ThomasKruger1234/EEE3088F-Project-2025/README.md

This repo contains the PCB design for the power distribution subsystem of a micromouse robot.

This design was created in fullfilment of the requirements of EEE3088F (UCT, 2025)
