ThomasKruger1234/EEE3088F-Project-2025/EEE3088F Project.kicad_pcb

## KiCad design EEE3088F Project.kicad_pcb (2025-03-28)

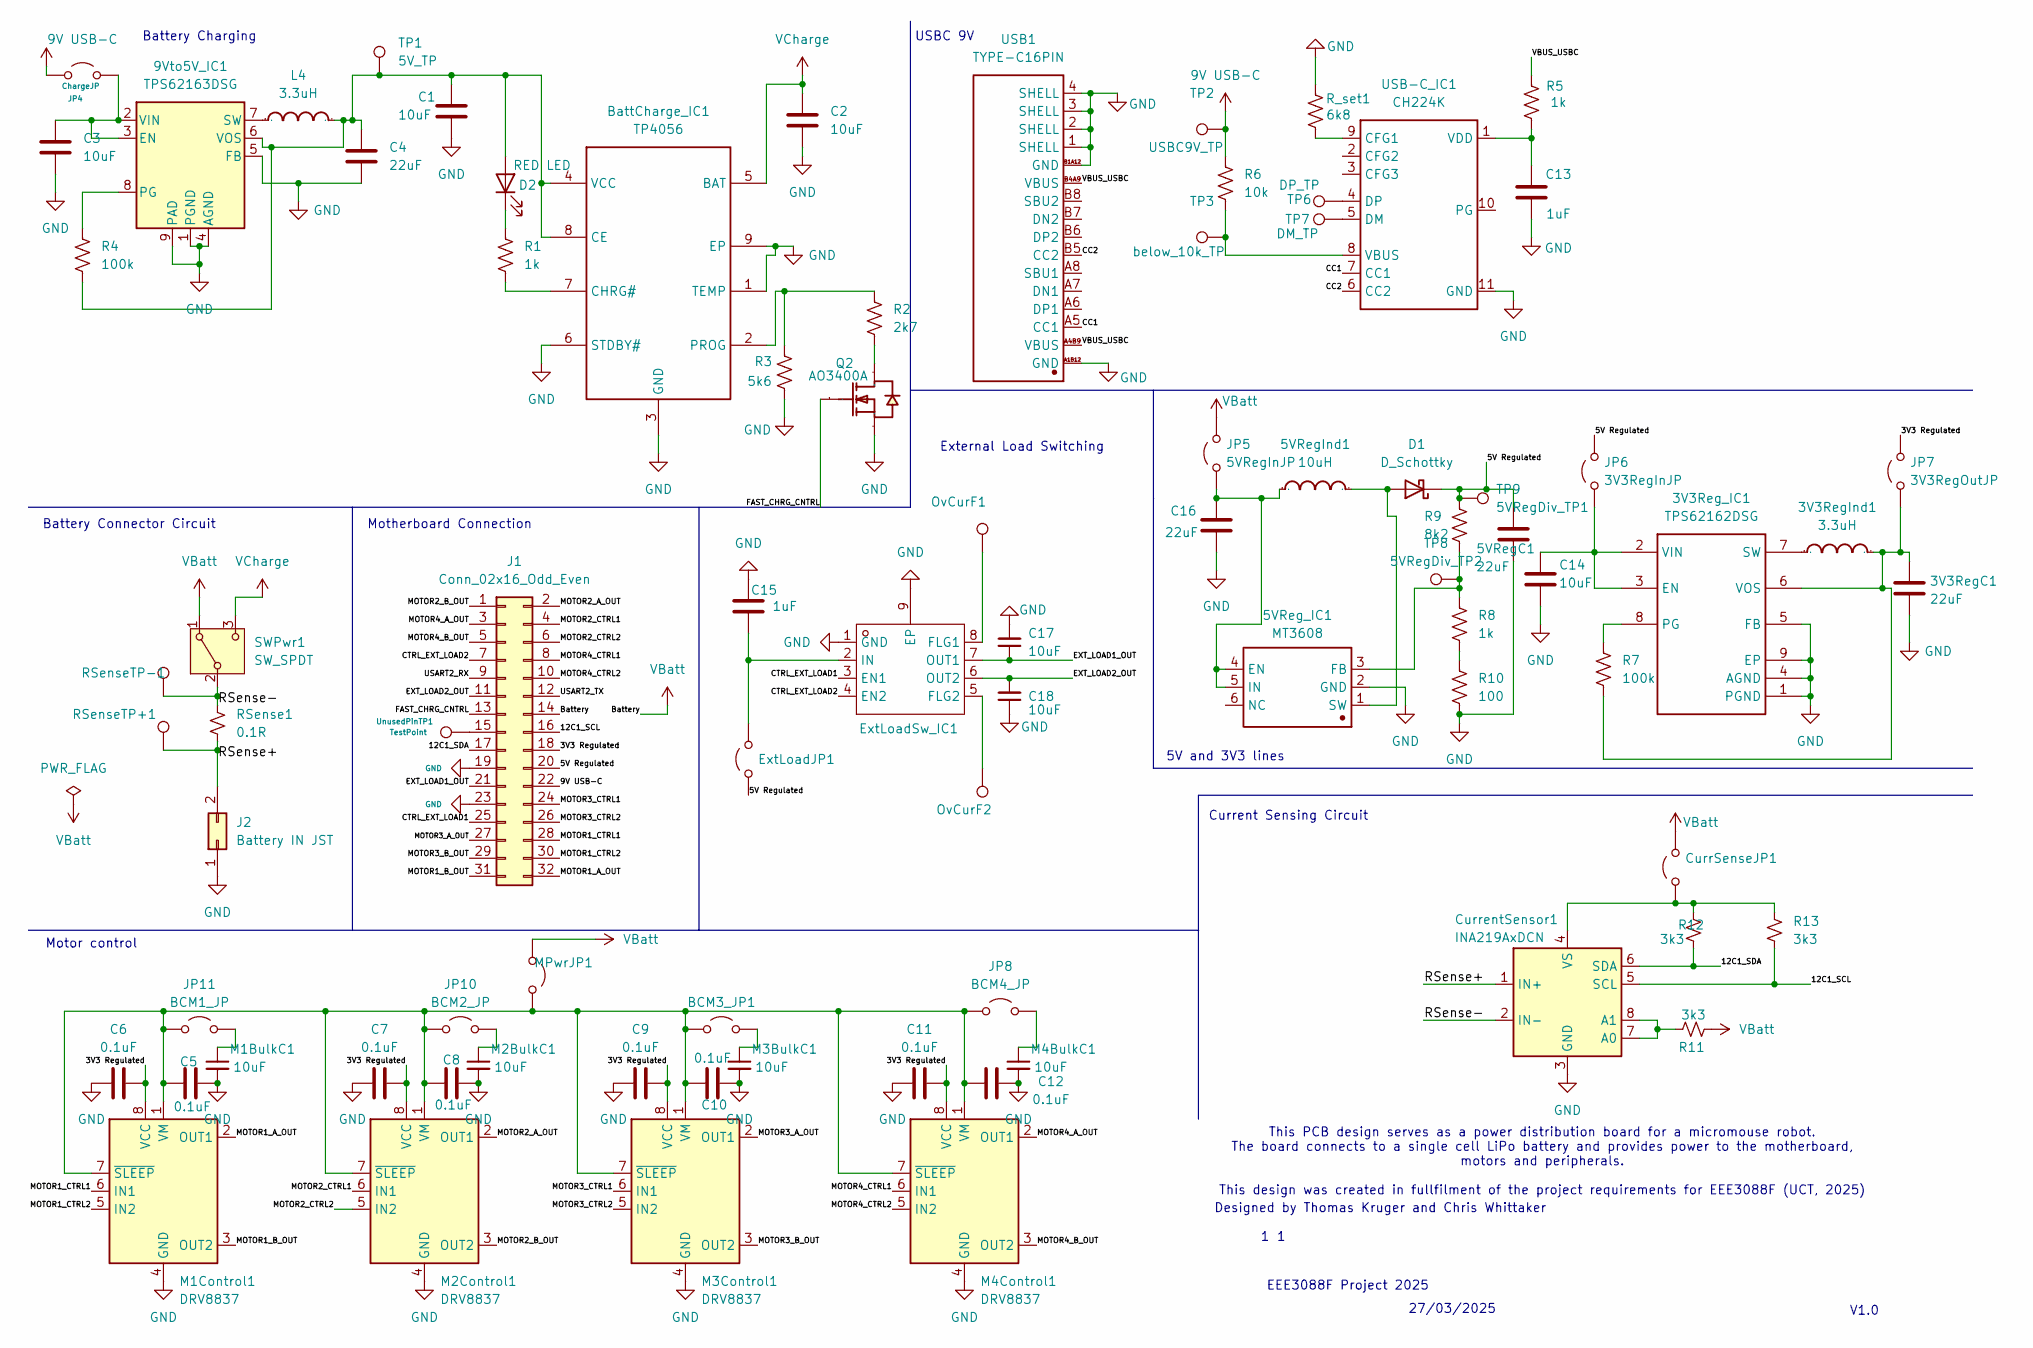
[picture p1: schematic EEE3088F Project.kicad_sch]

Parts:
3V3RegC1, 5VRegC1: 22uF; C_1206_3216Metric_Pad1.33x1.80mm_HandSolder
3V3RegInd1: 3.3uH; IND-SMD_L4.0-W4.0_FNR40XXS; Manufacturer Part FNR4030S3R3MT
3V3Reg_IC1: TPS62162DSG; WSON-8_L2.0-W2.0-P0.50-TL-EP; Manufacturer Part TPS62162DSGR
5VRegInd1: 10uH; IND-SMD_L7.8-W7.0-A; Manufacturer Part SM7850-100MT
5VReg_IC1: MT3608; SOT-23-6_L2.9-W1.6-P0.95-LS2.8-BL; Manufacturer Part MT3608
9Vto5V_IC1: TPS62163DSG; WSON-8_L2.0-W2.0-P0.50-TL-EP
BCM3_JP1: BCM3_JP; SolderJumper-2_P1.3mm_Open_Pad1.0x1.5mm
BattCharge_IC1: TP4056; ESOP-8_L4.9-W3.9-P1.27-LS6.0-BL-EP; Manufacturer Part TP4056-42-ESOP8
C1, C2, C3, C14, C17, C18: 10uF; C_0805_2012Metric_Pad1.18x1.45mm_HandSolder
C4, C16: 22uF; C_1206_3216Metric_Pad1.33x1.80mm_HandSolder
C5, C6, C7, C8, C9, C10, C11, C12: 0.1uF; C_0402_1005Metric_Pad0.74x0.62mm_HandSolder
C13, C15: 1uF; C_0603_1608Metric_Pad1.08x0.95mm_HandSolder
CurrSenseJP1: CurrentSenseJP; SolderJumper-2_P1.3mm_Open_Pad1.0x1.5mm
CurrentSensor1: INA219AxDCN; SOT-23-8
D1: D_Schottky; SMA_L4.3-W2.6-LS5.2-RD
D2: RED LED; LED_0805_2012Metric
ExtLoadJP1: ExtLoadJP; SolderJumper-2_P1.3mm_Open_Pad1.0x1.5mm
ExtLoadSw_IC1: MSOP-8_L3.0-W3.0-P0.65-LS4.9-BL-EP1.8; Manufacturer Part AP2192AMPG-13; LCSC Part Name Power Switch/Driver 1:2 P-Channel 1.5A 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
J1: Conn_02x16_Odd_Even; PinSocket_2x16_P2.54mm_Vertical
J2: Battery IN JST; PinSocket_1x02_P2.00mm_Vertical
JP4: ChargeJP; SolderJumper-2_P1.3mm_Open_Pad1.0x1.5mm
JP5: 5VRegInJP; SolderJumper-2_P1.3mm_Open_Pad1.0x1.5mm
JP6: 3V3RegInJP; SolderJumper-2_P1.3mm_Open_Pad1.0x1.5mm
JP7: 3V3RegOutJP; SolderJumper-2_P1.3mm_Open_Pad1.0x1.5mm
JP8: BCM4_JP; SolderJumper-2_P1.3mm_Open_Pad1.0x1.5mm
JP10: BCM2_JP; SolderJumper-2_P1.3mm_Open_Pad1.0x1.5mm
JP11: BCM1_JP; SolderJumper-2_P1.3mm_Open_Pad1.0x1.5mm
L4: 3.3uH; IND-SMD_L4.0-W4.0_FNR40XXS; Manufacturer Part FNR4030S3R3MT
M1BulkC1, M2BulkC1, M3BulkC1, M4BulkC1: 10uF; C_0805_2012Metric_Pad1.18x1.45mm_HandSolder
M1Control1, M2Control1, M3Control1, M4Control1: DRV8837; WSON-8-1EP_2x2mm_P0.5mm_EP0.9x1.6mm
MPwrJP1: MotorPWRJP; SolderJumper-2_P1.3mm_Open_Pad1.0x1.5mm
OvCurF1, OvCurF2: TestPoint; TestPoint_Pad_2.0x2.0mm
Q2: AO3400A; SOT-23-3_L2.9-W1.3-P1.90-LS2.4-BR; Manufacturer Part AO3400A
R1, R5, R8: 1k; R_0603_1608Metric_Pad0.98x0.95mm_HandSolder
R2: 2k7; R_0603_1608Metric_Pad0.98x0.95mm_HandSolder
R3: 5k6; R_0603_1608Metric_Pad0.98x0.95mm_HandSolder
R4, R7: 100k; R_0603_1608Metric_Pad0.98x0.95mm_HandSolder
R6: 10k; R_0603_1608Metric_Pad0.98x0.95mm_HandSolder
R9: 8k2; R_0603_1608Metric_Pad0.98x0.95mm_HandSolder
R10: 100; R_0603_1608Metric_Pad0.98x0.95mm_HandSolder
R11, R12, R13: 3k3; R_0603_1608Metric_Pad0.98x0.95mm_HandSolder
RSense1: 0.1R; R_1206_3216Metric_Pad1.30x1.75mm_HandSolder
RSenseTP+1: TestPoint; TestPoint_Pad_2.0x2.0mm
RSenseTP-1: TestPoint; TestPoint_Pad_2.0x2.0mm
R_set1: 6k8; R_0603_1608Metric_Pad0.98x0.95mm_HandSolder
SWPwr1: SW_SPDT; SW-TH_5P-P4.70_SS-12D11-G050
TP1: 5V_TP; TestPoint_Pad_2.0x2.0mm
TP2: USBC9V_TP; TestPoint_Pad_2.0x2.0mm
TP3: below_10k_TP; TestPoint_Pad_2.0x2.0mm
TP6: DP_TP; TestPoint_Pad_2.0x2.0mm
TP7: DM_TP; TestPoint_Pad_2.0x2.0mm
TP8: 5VRegDiv_TP2; TestPoint_Pad_2.0x2.0mm
TP9: 5VRegDiv_TP1; TestPoint_Pad_2.0x2.0mm
USB1: TYPE-C16PIN; USB-C-SMD_TYPE-C16PIN; Manufacturer Part TYPE-C16PIN
USB-C_IC1: CH224K; ESSOP-10_L4.9-W3.9-P1.0-LS6.0-TL-EP; Manufacturer Part CH224K
UnusedPinTP1: TestPoint; TestPoint_Pad_2.0x2.0mm

Connections:
9V USB-C: J1.22, JP4.1 (A), R6.1, TP2.1
/3V3 Regulated: C6.2, C7.2, C9.2, C11.2, J1.18, JP7.2 (B), M1Control1.8 (VCC), M2Control1.8 (VCC), M3Control1.8 (VCC), M4Control1.8 (VCC)
/5V Regulated: 5VRegC1.1, D1.1 (K), ExtLoadJP1.1 (A), J1.20, JP6.2 (B), R9.1, TP9.1; also elsewhere on the board
/12C1_SCL: CurrentSensor1.5 (SCL), J1.16, R13.2
/12C1_SDA: CurrentSensor1.6 (SDA), J1.17, R12.2
/CC1: USB1.A5 (CC1), USB-C_IC1.7 (CC1)
/CC2: USB1.B5 (CC2), USB-C_IC1.6 (CC2)
/CTRL_EXT_LOAD1: ExtLoadSw_IC1.3 (EN1), J1.25
/CTRL_EXT_LOAD2: ExtLoadSw_IC1.4 (EN2), J1.7
/EXT_LOAD1_OUT: C17.1, ExtLoadSw_IC1.7 (OUT1), J1.21
/EXT_LOAD2_OUT: C18.2, ExtLoadSw_IC1.6 (OUT2), J1.11
/FAST_CHRG_CNTRL: J1.13, Q2.1 (G)
/MOTOR1_A_OUT: J1.32, M1Control1.2 (OUT1)
/MOTOR1_B_OUT: J1.31, M1Control1.3 (OUT2)
/MOTOR1_CTRL1: J1.28, M1Control1.6 (IN1)
/MOTOR1_CTRL2: J1.30, M1Control1.5 (IN2)
/MOTOR2_A_OUT: J1.2, M2Control1.2 (OUT1)
/MOTOR2_B_OUT: J1.1, M2Control1.3 (OUT2)
/MOTOR2_CTRL1: J1.4, M2Control1.6 (IN1)
/MOTOR2_CTRL2: J1.6, M2Control1.5 (IN2)
/MOTOR3_A_OUT: J1.27, M3Control1.2 (OUT1)
/MOTOR3_B_OUT: J1.29, M3Control1.3 (OUT2)
/MOTOR3_CTRL1: J1.24, M3Control1.6 (IN1)
/MOTOR3_CTRL2: J1.26, M3Control1.5 (IN2)
/MOTOR4_A_OUT: J1.3, M4Control1.2 (OUT1)
/MOTOR4_B_OUT: J1.5, M4Control1.3 (OUT2)
/MOTOR4_CTRL1: J1.8, M4Control1.6 (IN1)
/MOTOR4_CTRL2: J1.10, M4Control1.5 (IN2)
/RSense+: CurrentSensor1.1 (IN+), J2.2, RSense1.2, RSenseTP+1.1
/RSense-: CurrentSensor1.2 (IN-), RSense1.1, RSenseTP-1.1, SWPwr1.2 (B)
/USART2_RX: J1.9
/USART2_TX: J1.12
/VBUS_USBC: R5.1, USB1.A4B9 (VBUS), USB1.B4A9 (VBUS)
GND: 3V3RegC1.2, 3V3Reg_IC1.1 (PGND), 3V3Reg_IC1.4 (AGND), 3V3Reg_IC1.5 (FB), 3V3Reg_IC1.9 (EP), 5VRegC1.2, 5VReg_IC1.2 (GND), 9Vto5V_IC1.1 (PGND), 9Vto5V_IC1.4 (AGND), 9Vto5V_IC1.5 (FB), 9Vto5V_IC1.9 (PAD), BattCharge_IC1.1 (TEMP), BattCharge_IC1.3 (GND), BattCharge_IC1.6 (STDBY#), BattCharge_IC1.9 (EP), C1.1, C2.2, C3.2, C4.2, C5.2, C6.1, C7.1, C8.2, C9.1, C10.2, C11.1, C12.2, C13.2, C14.2, C15.2, C16.2, C17.2, C18.1, CurrentSensor1.3 (GND), ExtLoadSw_IC1.1 (GND), ExtLoadSw_IC1.9 (EP), J1.19, J1.23, J2.1, M1BulkC1.2, M1Control1.4 (GND), M1Control1.9 (GND), M2BulkC1.2, M2Control1.4 (GND), M2Control1.9 (GND), M3BulkC1.2, M3Control1.4 (GND), M3Control1.9 (GND), M4BulkC1.2, M4Control1.4 (GND), M4Control1.9 (GND), Q2.2 (S), R3.2, R10.2, R_set1.2, USB1.1 (SHELL), USB1.2 (SHELL), USB1.3 (SHELL), USB1.4 (SHELL), USB1.A1B12 (GND), USB1.B1A12 (GND), USB-C_IC1.11 (GND)
unnamed: 3V3Reg_IC1.2 (VIN), 3V3Reg_IC1.3 (EN), C14.1, JP6.1 (A)
unnamed: 3V3Reg_IC1.8 (PG), R7.1
unnamed: 3V3RegInd1.1, 3V3Reg_IC1.7 (SW)
unnamed: 3V3RegC1.1, 3V3RegInd1.2, 3V3Reg_IC1.6 (VOS), JP7.1 (A), R7.2
unnamed: 5VRegInd1.1, 5VReg_IC1.4 (EN), 5VReg_IC1.5 (IN), C16.1, JP5.1 (A)
unnamed: 5VReg_IC1.3 (FB), R8.1, R9.2, TP8.1
unnamed: 5VRegInd1.2, 5VReg_IC1.1 (SW), D1.2 (A)
unnamed: 9Vto5V_IC1.2 (VIN), 9Vto5V_IC1.3 (EN), C3.1, JP4.2 (B)
unnamed: 9Vto5V_IC1.8 (PG), R4.1
unnamed: 9Vto5V_IC1.7 (SW), L4.1
unnamed: 9Vto5V_IC1.6 (VOS), BattCharge_IC1.4 (VCC), BattCharge_IC1.8 (CE), C1.2, C4.1, D2.2 (A), L4.2, R4.2, TP1.1
unnamed: BCM3_JP1.1 (A), C5.1, C8.1, C10.1, C12.1, JP8.1 (A), JP10.1 (A), JP11.1 (A), M1Control1.1 (VM), M1Control1.7 (~SLEEP), M2Control1.1 (VM), M2Control1.7 (~SLEEP), M3Control1.1 (VM), M3Control1.7 (~SLEEP), M4Control1.1 (VM), M4Control1.7 (~SLEEP), MPwrJP1.2 (B)
unnamed: BCM3_JP1.2 (B), M3BulkC1.1
unnamed: BattCharge_IC1.7 (CHRG#), R1.2
unnamed: BattCharge_IC1.2 (PROG), R2.1, R3.1
unnamed: CurrSenseJP1.1 (A), CurrentSensor1.4 (VS), R12.1, R13.1
unnamed: CurrentSensor1.7 (A0), CurrentSensor1.8 (A1), R11.1
unnamed: D2.1 (K), R1.1
unnamed: C15.1, ExtLoadJP1.2 (B), ExtLoadSw_IC1.2 (IN)
unnamed: ExtLoadSw_IC1.8 (FLG1), OvCurF1.1
unnamed: ExtLoadSw_IC1.5 (FLG2), OvCurF2.1
unnamed: J1.15, UnusedPinTP1.1
unnamed: JP8.2 (B), M4BulkC1.1
unnamed: JP10.2 (B), M2BulkC1.1
unnamed: JP11.2 (B), M1BulkC1.1
unnamed: Q2.3 (D), R2.2
unnamed: R8.2, R10.1
unnamed: R_set1.1, USB-C_IC1.9 (CFG1)
unnamed: TP7.1, USB-C_IC1.5 (DM)
unnamed: TP6.1, USB-C_IC1.4 (DP)
unnamed: R6.2, TP3.1, USB-C_IC1.8 (VBUS)
unnamed: C13.1, R5.2, USB-C_IC1.1 (VDD)
VBatt: CurrSenseJP1.2 (B), J1.14, JP5.2 (B), MPwrJP1.1 (A), R11.2, SWPwr1.1 (A)
VCharge: BattCharge_IC1.5 (BAT), C2.1, SWPwr1.3 (C)

Notes on the sheet:
Motor control
27/03/2025
External Load Switching
V1.0
USBC 9V
Battery Charging
Battery Connector Circuit
5V and 3V3 lines
EEE3088F Project 2025
Motherboard Connection
Designed by Thomas Kruger and Chris Whittaker
Current Sensing Circuit
This PCB design serves as a power distribution board for a micromouse robot. The board connects to a single cell LiPo battery and provides power to the motherboard, motors and peripherals. This design was created in fullfilment of the project requirements for EEE3088F (UCT, 2025)

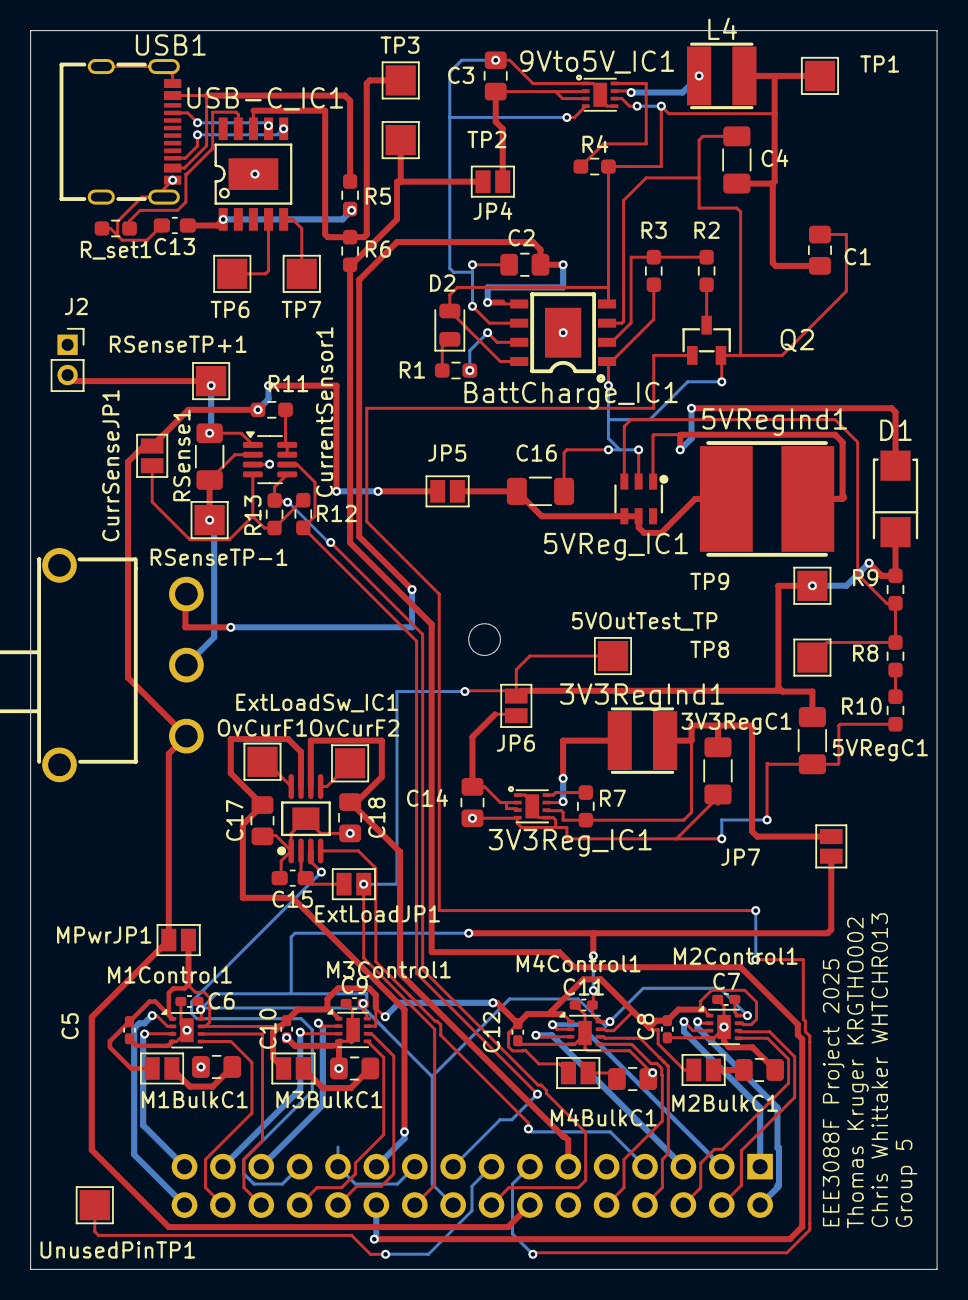
[picture p2: board EEE3088F Project.kicad_pcb from above]

Board: 2 copper layers, 60.0 x 82.0 mm, 84 parts (1 on the bottom side), 66 nets.

Other parts of the board:
5VOutTest_TP: 5V_out_test; TestPoint_Pad_2.0x2.0mm

Their connections:
/5V Regulated: 5VOutTest_TP.1; also elsewhere on the board
