ThomasKruger1234/EEE3088F-Project-2025/(commit log)

2025-03-21 Created KiCad file and added pin headers
    [EEE3088F Project.kicad_pcb, EEE3088F Project.kicad_sch]
2025-03-21 test push/pull
    [EEE3088F Project.kicad_sch]
2025-03-21 added battery charging subsection (no footprints yet)
    [EEE3088F Project.kicad_sch]
2025-03-21 Added motor driver circuits and footprints
    [EEE3088F Project.kicad_pcb, EEE3088F Project.kicad_sch]
2025-03-22 started on current sensing circuit
    [EEE3088F Project.kicad_sch]
2025-03-22 changed battery charging circuit's buck converter and added mosfet circuit for charging mode selection
    [EEE3088F Project.kicad_pcb, EEE3088F Project.kicad_sch]
2025-03-23 Finished current sensor circuit, finished battery connector circuit. Added footprints and BOM info for all.
    [EEE3088F Project.kicad_pcb, EEE3088F Project.kicad_sch]
2025-03-23 added 3V3 and 5V out circuitry as well as USBC
    [CPL-EEE3088F Project.csv, EEE3088F Project-CuBottom.gbr, EEE3088F Project-CuTop.gbr, EEE3088F Project-EdgeCuts.gbr, EEE3088F Project-MaskBottom.gbr, EEE3088F Project-MaskTop.gbr, EEE3088F Project-NPTH.drl, EEE3088F Project-PTH.drl]
2025-03-23 removed gerbers generated by mistake
    [CPL-EEE3088F Project.csv, EEE3088F Project-CuBottom.gbr, EEE3088F Project-CuTop.gbr, EEE3088F Project-EdgeCuts.gbr, EEE3088F Project-MaskBottom.gbr, EEE3088F Project-MaskTop.gbr, EEE3088F Project-NPTH.drl, EEE3088F Project-PTH.drl]
2025-03-24 corrected footprints for usbc and schottky diode
    [EEE3088F Project.kicad_pcb, EEE3088F Project.kicad_sch]
2025-03-24 added custom symbol and placed usbc and schottky custom footprints into custom footprints.pretty
    [EEE3088F Project.kicad_pcb, EEE3088F Project.kicad_sch]
2025-03-24 Cleaned up battery charging circuit and added Battery, 3V3_out and 5V_out labels to motherboard connection
    [EEE3088F Project.kicad_pcb, EEE3088F Project.kicad_sch]
2025-03-24 Added external load switching circuit
    [EEE3088F Project.kicad_sch]
2025-03-25 checked footprints and finished BOM for my components
    [EEE3088F Project.kicad_pcb]
2025-03-25 Fixed BOM
    [EEE3088F Project.kicad_pcb, EEE3088F Project.kicad_sch]
2025-03-25 changed inductors
    [EEE3088F Project.kicad_pcb, EEE3088F Project.kicad_sch]
2025-03-27 Routed Thomas half of PCB traces. Minor labelling modifications in schematic.
    [EEE3088F Project.kicad_pcb, EEE3088F Project.kicad_sch]
2025-03-27 finished routing
    [EEE3088F Project.kicad_pcb]
2025-03-27 added and fixed traces and trace widths. Fixed design rule check errors
    [EEE3088F Project.kicad_pcb]
2025-03-27 Minor labelling fixes. Generated gerber files
    [BOM-EEE3088F Project.csv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]
2025-03-28 ensuring all changes committed
    [EEE3088F Project.kicad_pcb]
2025-03-28 added thicker lines for 9V, 5V, VBatt and 3V3
    [EEE3088F Project.kicad_pcb]
2025-03-28 Finishing touches + mounting hole
    [EEE3088F Project-CuBottom.gbr, EEE3088F Project-CuTop.gbr, EEE3088F Project-EdgeCuts.gbr, EEE3088F Project-MaskBottom.gbr, EEE3088F Project-MaskTop.gbr, EEE3088F Project-NPTH.drl, EEE3088F Project-PTH.drl, EEE3088F Project-SilkBottom.gbr]
